AureolePosey/sentinel-X-G2/boitier/apercu_eclate.png

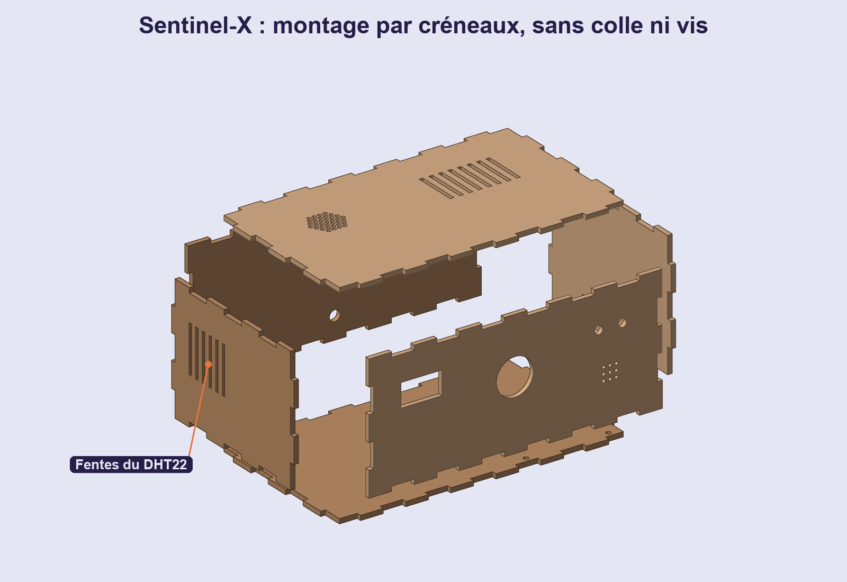
boitier/apercu_eclate.png
