AureolePosey/sentinel-X-G2/boitier/decoupe_A4.png

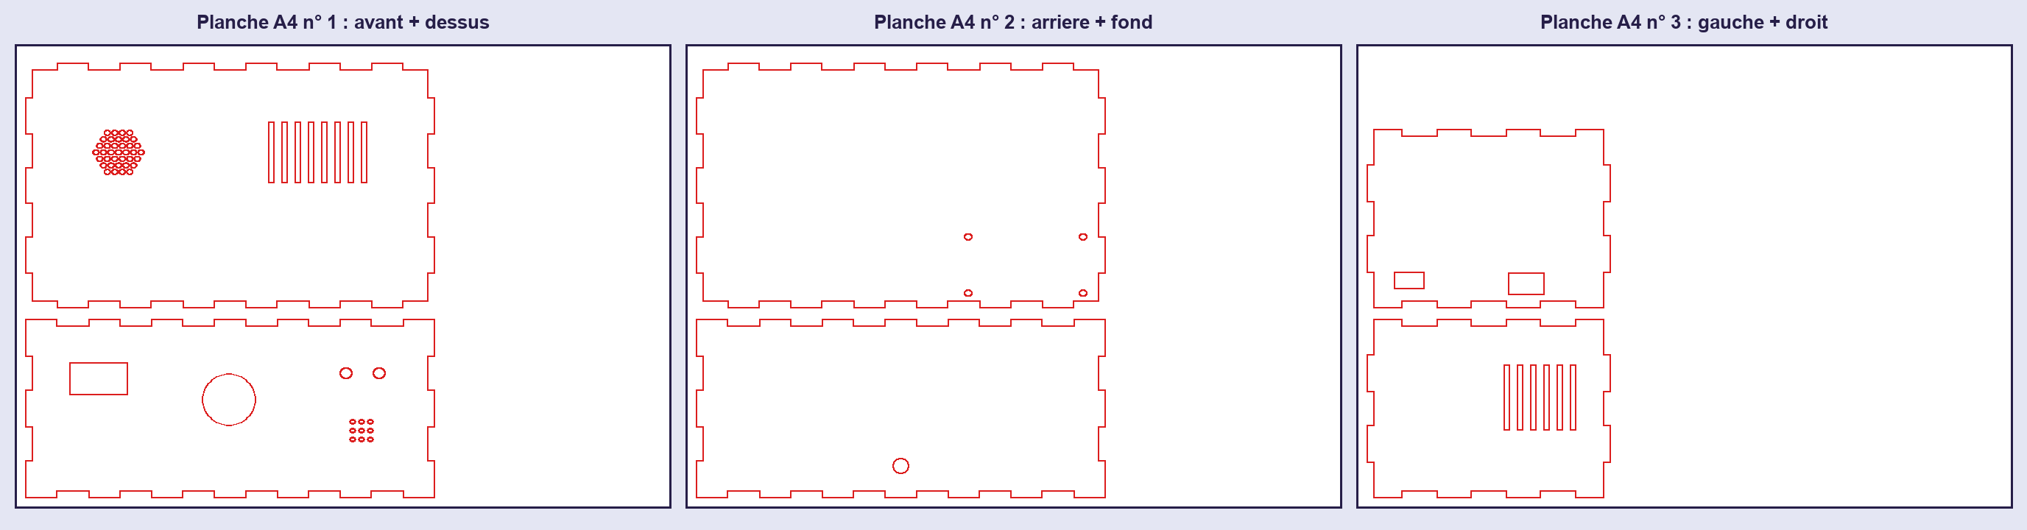
boitier/decoupe_A4.png
