AureolePosey/sentinel-X-G2/docs/images/cablage.png

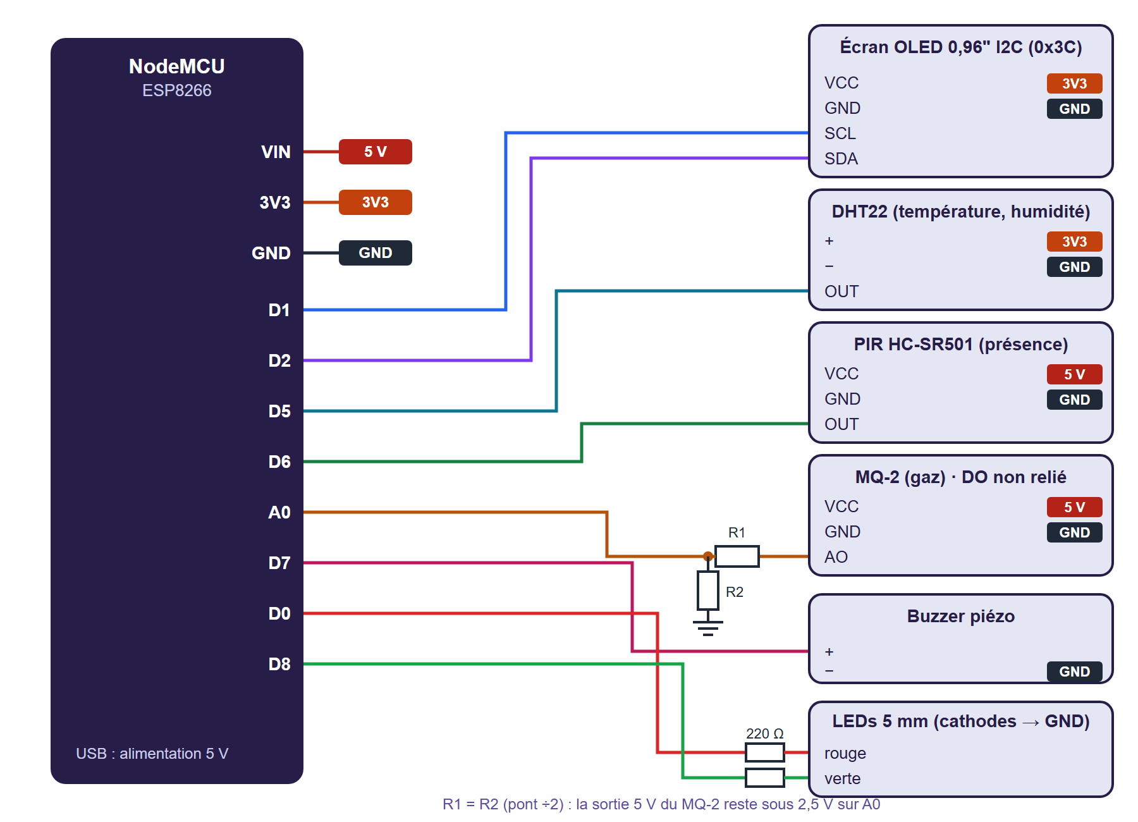
docs/images/cablage.png
