AureolePosey/sentinel-X-G2/docs/images/vision-yolo.jpg

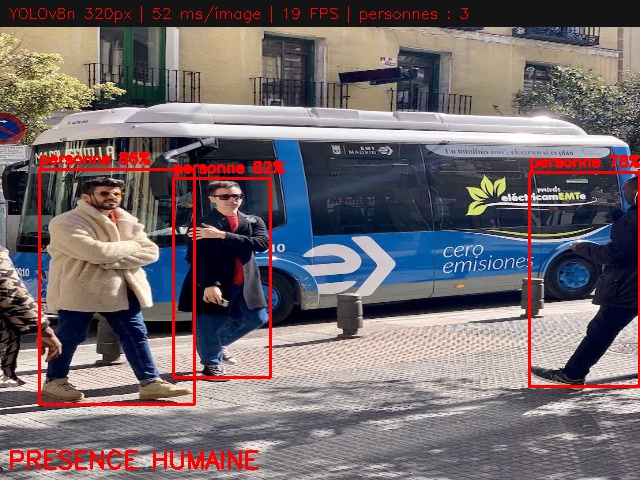
docs/images/vision-yolo.jpg
