AureolePosey/sentinel-X-G2/boitier/decoupe_A4_1.dxf

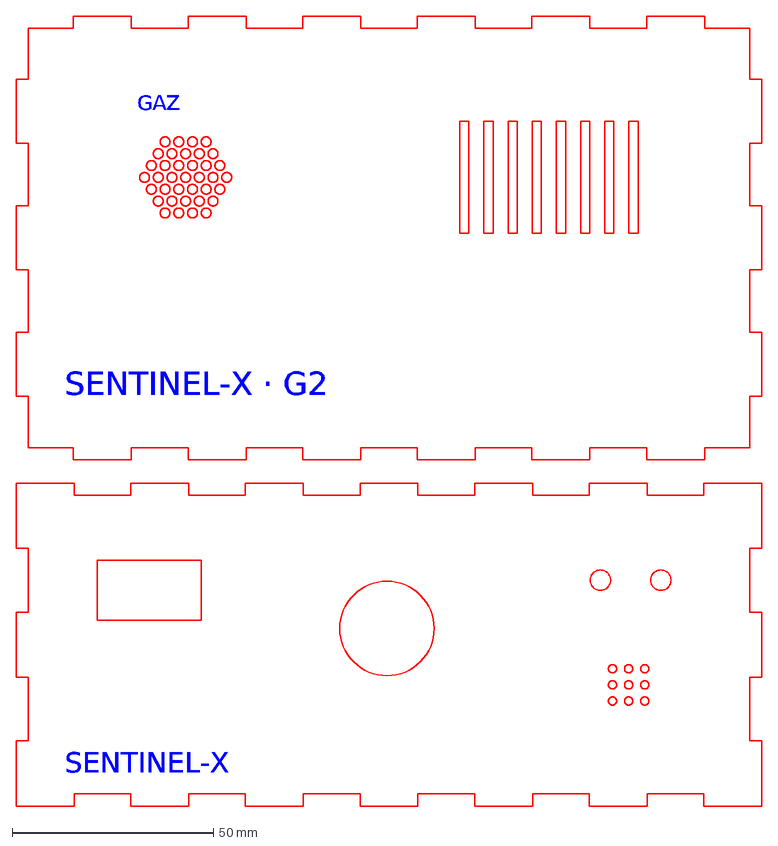
[picture p9: CAD file, 2026-10-10]
boitier/decoupe_A4_1.dxf
SENTINEL-X
SENTINEL-X · G2
GAZ
