AureolePosey/sentinel-X-G2/boitier/decoupe_A4_3.dxf

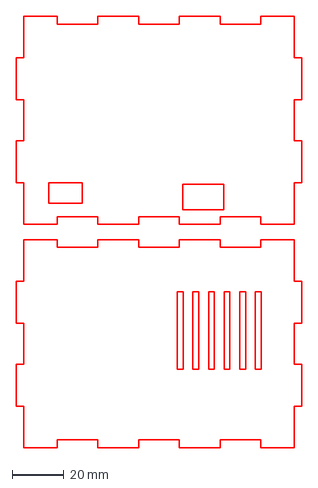
[picture p10: CAD file, 2026-10-10]
boitier/decoupe_A4_3.dxf
110.2 x 166.1 mm
