AureolePosey/sentinel-X-G2/boitier/decoupe_A4_2.dxf

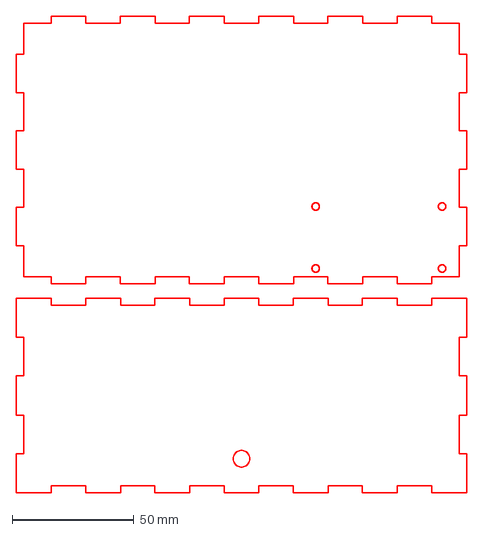
[picture p11: CAD file, 2026-10-10]
boitier/decoupe_A4_2.dxf
185.2 x 196.1 mm
